zyj2659/-proteus-cpu-/README.md

# -proteus-cpu-
基于Proteus进行了CPU设计，可以帮助理解CPU中的指令，总线，指令如何通过寄存器实现等，对于微机原理的理解有帮助。
在8086的一些基础功能中选择了部分实现，还尝试是实现了单片机的中断功能，在文档中可以看到设计思路。
