zyj2659/-proteus-cpu-/(list of files, drawings)

Other design files:
微型cpu设计.pdsprj
